inspireFly-VT/ContentCube_Payload_Board/README.md

View this project on [CADLAB.io](https://cadlab.io/project/28566). 

# ContentCube_Payload_Board
The payload board for inspireFly's ContentCube satellite.
