inspireFly-VT/ContentCube_Payload_Board/Documentation/Adafruit-1.5-display/camera_oled_software/inspireFly_soft_09_06_2024_1206/README.md

# Functional-OLED-and-Camera-Program
Working software to display on the ADAFruit SSD1351 and capture images from the Arducam 3MP on one main program. Documentation is WIP.
