inspireFly-VT/ContentCube_Payload_Board/Payload_BlockDiagram.pptx

inspireFly Payload Board Block Diagram– 10/10/2023 – L.V.

* Camera has I2C connectivity for “config/setup” (optional)

Number markings indicate importance

RP2040

Flight
Controller

1

Camera

2

I2C*

I2C

Display

SPI

3

RP2040

Payload Controller

QSPI

QSPI

External
Flash

Both may not be required

5

SD Card

4
