inspireFly-VT/ContentCube_Payload_Board/Documentation/Adafruit-1.5-display/camera_oled_software/inspireFly_soft_08_25_24_1240/inspireFly_Capture_0.jpg

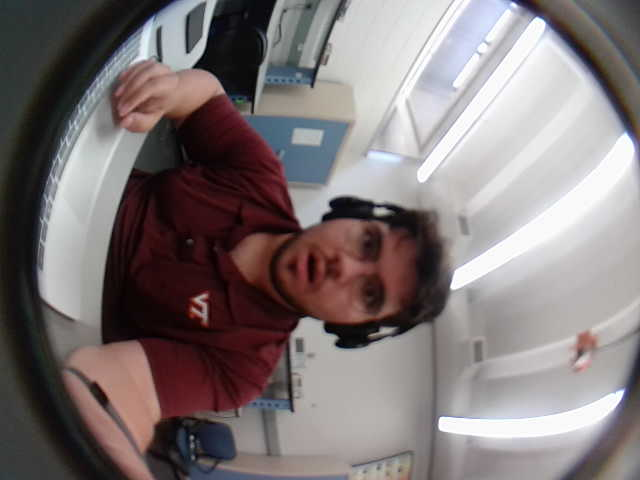
Documentation/Adafruit-1.5-display/camera_oled_software/inspireFly_soft_08_25_24_1240/inspireFly_Capture_0.jpg
