inspireFly-VT/ContentCube_Payload_Board/Documentation/Adafruit-1.5-display/camera_oled_software/inspireFly_soft_09_06_2024_1206/inspireFly_Capture_2.jpg

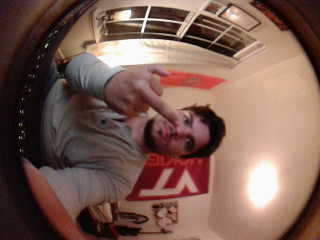
Documentation/Adafruit-1.5-display/camera_oled_software/inspireFly_soft_09_06_2024_1206/inspireFly_Capture_2.jpg
