inspireFly-VT/ContentCube_Payload_Board/Manufacturing/payload_board.xlsx

Sheet: payload_board_1
Id | Designator | Footprint | Quantity | Designation | JLC PN | DK PN | Inv | Needed | Column2
26 | C13 | C_1206_3216Metric_Pad1.33x1.80mm_HandSolder | 1 | 22uF |  | 1276-3148-2-ND | 1 | 4
11 | C12 | C_1206_3216Metric_Pad1.33x1.80mm_HandSolder | 1 | 10uF |  | 1276-6641-1-ND | 8 | 0
8 | C19,C14,C6,C23,C22 | C_0402_1005Metric_Pad0.74x0.62mm_HandSolder | 5 | 1uF | C77006
6 | C2,C1 | C_0402_1005Metric_Pad0.74x0.62mm_HandSolder | 2 | 27pF | C86287 |  | 10
18 | C20,C21,C24 | C_0603_1608Metric_Pad1.08x0.95mm_HandSolder | 2 | 10uF/16V | C962136 |  | 27
31 | C26 | R_0805_2012Metric_Pad1.20x1.40mm_HandSolder | 1 | 4.7uF |  | 1276-1244-1-ND | 2 | 3
2 | C8,C10,C7,C4,C16,C5,C15,C11,C17,C9 | C_0402_1005Metric_Pad0.74x0.62mm_HandSolder | 10 | 0.1uF | C60474 |  | 30
44 | D2 | LED_0805_2012Metric | 1 | LED BL |  | 732-4982-1-ND | 3 | 2
 | D3 | LED_0805_2012Metric | 1 | LED GR |  |  | 6 | 0
 | D4 | LED_0805_2012Metric | 1 | LED RED |  | 732-4984-1-ND | 2 | 3
3 | D7,D1,D5 | D_SOD-323 | 3 | NSR0320 | C48192
19 | IC1 | custom_IC57_RP2040 | 1 | RP2040_QFN56 | C2040
35 | IC2 | SOT230P700X180-4N | 1 | AZ1117CH-3.3TRG1 |  | AZ1117CH-3.3TRG1DICT-ND | 5 | 0
14 | J1,J6 | Molex_Pico_CON_5040500691 | 2 | Cam_PicoLock, Breakout |  | WM10143CT-ND | 6 | 4
27 | J10 | MOLEX_503398-1892 | 1 | 503398-1892 |  | WM11190CT-ND | 4 | 1
32 | J3 | Molex_Pico_CON_5040500491 | 1 | Antenna_Conn |  | WM10137CT-ND | 2 | 3
46 | J7 | MOLEX_105164-0001 | 1 | Molex_Micro_USB |  | WM11263CT-ND | 1 | 4
4 | J8 | MOLEX_504050-0291 | 1 | FC to EPS Connector |  | WM25693CT-ND | 3 | 2
29 | L1 | L_1008_2520Metric_Pad1.43x2.20mm_HandSolder | 1 | 10uH/1A |  | 535-AOTA-B252010S100MTCT-ND | 2 | 3
24 | Q1 | SC-59 | 1 | Q_PMOS_GSD | C2589
43 | R10,R12 | R_0402_1005Metric_Pad0.72x0.64mm_HandSolder | 2 | 220 |  | 2019-RK73H1ETTP2200FCT-ND | 10 | 0
47 | R11 | R_0402_1005Metric_Pad0.72x0.64mm_HandSolder | 1 | 820 |  |  | 0 | 5
5 | R13,R14 | R_1206_3216Metric_Pad1.30x1.75mm_HandSolder | 2 | 0.065 | C20608721 |  | 7
33 | R15,R16 | R_0603_1608Metric_Pad0.98x0.95mm_HandSolder | 2 | 300k | C138011
1 | R19 | R_0603_1608Metric_Pad0.98x0.95mm_HandSolder | 1 | 50 | C853312
15 | R20 | R_0805_2012Metric_Pad1.20x1.40mm_HandSolder | 1 | 16k |  | 2019-RK73H2ATTD1002FTR-ND | 1 | 4
16 | R3,R1,R8,R9 | R_0402_1005Metric_Pad0.72x0.64mm_HandSolder | 3 | 10k | C144731 |  | 6
12 | R5,R6 | R_0402_1005Metric_Pad0.72x0.64mm_HandSolder | 2 | 27.4 | C274349
7 | R7,R2,R21 | R_0402_1005Metric_Pad0.72x0.64mm_HandSolder | 2 | 1K | C136974 |  | 20
38 | SW2,SW1 | SW_Push_1P1T_NO_CK_KMR2 | 2 | KMR2 | C221675
25 | U1 | WDFN-8-1EP_6x5mm_P1.27mm_EP3.4x4mm | 1 | W25Q128JVPIQ TR | C190862
37 | U2 | SOIC-8_3.9x4.9mm_P1.27mm | 1 | MAX706RESA |  | MAX706RESA+CT-ND | 3 | 2
9 | U4,U3 | SOT-23-5 | 2 | INA180A3 |  | 296-47654-1-ND | 4 | 6
28 | U6 | CON30_1X30_DRB_XF2C_TYC | 1 | ~ | C3041205
30 | U7 | SOT-23-6 | 1 | TLV61046ADB | C464815
34 | Y1 | Crystal_SMD_5032-2Pin_5.0x3.2mm | 1 | ABLS-12.000MHZ-B2-T |  | CTX1162CT-ND | 0 | 5

Sheet: payload_board_074 (4)
Id | Designator | Footprint | Quantity | Designation | JLC PN | DK PN | Inv | Needed | Column2
26 | C13 | C_1206_3216Metric_Pad1.33x1.80mm_HandSolder | 1 | 22uF |  | 1276-3148-2-ND | 6 | 0
11 | C12 | C_1206_3216Metric_Pad1.33x1.80mm_HandSolder | 1 | 10uF |  | 1276-6641-1-ND | 8 | 0
8 | C19,C14,C6,C23,C22 | C_0402_1005Metric_Pad0.74x0.62mm_HandSolder | 5 | 1uF | C77006
6 | C2,C1 | C_0402_1005Metric_Pad0.74x0.62mm_HandSolder | 2 | 27pF | C86287
18 | C20,C21,C24 | C_0603_1608Metric_Pad1.08x0.95mm_HandSolder | 2 | 10uF/16V | C962136
31 | C26 | R_0805_2012Metric_Pad1.20x1.40mm_HandSolder | 1 | 4.7uF |  | 1276-1244-1-ND | 0 | 5
2 | C8,C10,C7,C4,C16,C5,C15,C11,C17,C9 | C_0402_1005Metric_Pad0.74x0.62mm_HandSolder | 10 | 0.1uF | C60474
44 | D2 | LED_0805_2012Metric | 1 | LED BL |  | 732-4982-1-ND | 3 | 2
 | D3 | LED_0805_2012Metric | 1 | LED GR |  |  | 6 | 0
 | D4 | LED_0805_2012Metric | 1 | LED RED |  | 732-4984-1-ND | 0 | 5
3 | D7,D1,D5 | D_SOD-323 | 3 | NSR0320 | C48192
19 | IC1 | custom_IC57_RP2040 | 1 | RP2040_QFN56 | C2040
35 | IC2 | SOT230P700X180-4N | 1 | AZ1117CH-3.3TRG1 |  | AZ1117CH-3.3TRG1DICT-ND | 10 | 0
14 | J1,J6 | Molex_Pico_CON_5040500691 | 2 | Cam_PicoLock, Breakout |  | WM10143CT-ND | 9 | 1
27 | J10 | MOLEX_503398-1892 | 1 | 503398-1892 |  | WM11190CT-ND | 6 | 0
32 | J3 | Molex_Pico_CON_5040500491 | 1 | Antenna_Conn |  | WM10137CT-ND | 5 | 0
46 | J7 | MOLEX_105164-0001 | 1 | Molex_Micro_USB |  | WM11263CT-ND | 1 | 4
4 | J8 | MOLEX_504050-0291 | 1 | FC to EPS Connector |  | WM25693CT-ND | 5 | 0
29 | L1 | L_1008_2520Metric_Pad1.43x2.20mm_HandSolder | 1 | 10uH/1A |  | 535-AOTA-B252010S100MTCT-ND | 5 | 0
24 | Q1 | SC-59 | 1 | Q_PMOS_GSD | C2589
43 | R10,R12 | R_0402_1005Metric_Pad0.72x0.64mm_HandSolder | 2 | 220 |  | 2019-RK73H1ETTP2200FCT-ND | 10 | 0
47 | R11 | R_0402_1005Metric_Pad0.72x0.64mm_HandSolder | 1 | 470 |  | 2019-RK73H1ETTP4700FTR-ND | 3 | 2
5 | R13,R14 | R_1206_3216Metric_Pad1.30x1.75mm_HandSolder | 2 | 0.065 | C20608721
33 | R15,R16 | R_0603_1608Metric_Pad0.98x0.95mm_HandSolder | 2 | 300k | C138011
1 | R19 | R_0603_1608Metric_Pad0.98x0.95mm_HandSolder | 1 | 50 | C853312
15 | R20 | R_0805_2012Metric_Pad1.20x1.40mm_HandSolder | 1 | 16k |  | 2019-RK73H2ATTD1002FTR-ND | 0 | 5
16 | R3,R1,R8,R9 | R_0402_1005Metric_Pad0.72x0.64mm_HandSolder | 3 | 10k | C144731
12 | R5,R6 | R_0402_1005Metric_Pad0.72x0.64mm_HandSolder | 2 | 27.4 | C274349
7 | R7,R2,R21 | R_0402_1005Metric_Pad0.72x0.64mm_HandSolder | 2 | 1K | C136974
38 | SW2,SW1 | SW_Push_1P1T_NO_CK_KMR2 | 2 | KMR2 | C221675
25 | U1 | WDFN-8-1EP_6x5mm_P1.27mm_EP3.4x4mm | 1 | W25Q128JVPIQ TR | C190862
37 | U2 | SOIC-8_3.9x4.9mm_P1.27mm | 1 | MAX706RESA |  | MAX706RESA+CT-ND | 5 | 0
9 | U4,U3 | SOT-23-5 | 2 | INA180A3 |  | 296-47654-1-ND | 3 | 7
28 | U6 | CON30_1X30_DRB_XF2C_TYC | 1 | ~ | C3041205
30 | U7 | SOT-23-6 | 1 | TLV61046ADB | C464815
34 | Y1 | Crystal_SMD_5032-2Pin_5.0x3.2mm | 1 | ABLS-12.000MHZ-B2-T |  | CTX1162CT-ND | 0 | 5

Sheet: payload_board_074
Id | Designator | Footprint | Quantity | Designation | JLC PN | Column1 | _1
39 | C12 | C_1206_3216Metric_Pad1.33x1.80mm_HandSolder | 1 | 10uF
24 | C13 | C_1206_3216Metric_Pad1.33x1.80mm_HandSolder | 1 | 22uF
8 | C2,C1 | C_0402_1005Metric_Pad0.74x0.62mm_HandSolder | 2 | 27pF | C86287
2 | C21,C20 | C_0603_1608Metric_Pad1.08x0.95mm_HandSolder | 2 | 10uF/16V | C962136
20 | C23,C14,C6,C22 | C_0402_1005Metric_Pad0.74x0.62mm_HandSolder | 4 | 1uF | C77006
1 | C24,C19,C18 | C_0603_1608Metric_Pad1.08x0.95mm_HandSolder | 3 | 10uF | C962136
4 | C8,C10,C7,C4,C16,C5,C15,C25,C11,C17,C9 | C_0402_1005Metric_Pad0.74x0.62mm_HandSolder | 11 | 0.1uF | C60474
41 | D2,D3,D4 | LED_0805_2012Metric | 3 | LED | C7371915
5 | D7,D9,D1,D5 | D_SOD-323 | 4 | NSR0320 | C48192
18 | IC1 | custom_IC57_RP2040 | 1 | RP2040_QFN56 | C2040
31 | IC2 | SOT230P700X180-4N | 1 | AZ1117CH-3.3TRG1
42 | J_Burn | Burn_Wire_Connection | 1 | Conn_01x02
15 | J1 | Molex_Pico_CON_5040500691 | 1 | Cam_PicoLock
25 | J10 | MOLEX_503398-1892 | 1 | 503398-1892
21 | J12 | PinHeader_1x02_P2.54mm_Vertical | 1 | FC Breakout
16 | J15 | PinHeader_1x06_P2.54mm_Vertical | 1 | SWC
14 | J2 | PinHeader_1x06_P2.54mm_Vertical | 1 | Cam_Conn
27 | J3 | Molex_Pico_CON_5040500491 | 1 | Antenna_Conn
19 | J4 | SolderJumper-2_P1.3mm_Open_TrianglePad1.0x1.5mm | 1 | usb jumper
35 | J6 | Molex_Pico_CON_5040500691 | 1 | Breakout
43 | J7 | MOLEX_105164-0001 | 1 | Molex_Micro_USB
6 | J8 | MOLEX_504050-0291 | 1 | FC to EPS Connector
37 | L1 | L_1008_2520Metric_Pad1.43x2.20mm_HandSolder | 1 | 10uH/1A
22 | Q1 | SC-59 | 1 | Q_PMOS_GSD | C2589
40 | R10,R12 | R_0402_1005Metric_Pad0.72x0.64mm_HandSolder | 2 | 220 | C112291
44 | R11 | R_0402_1005Metric_Pad0.72x0.64mm_HandSolder | 1 | 470 | C114949
7 | R13,R14 | R_1206_3216Metric_Pad1.30x1.75mm_HandSolder | 2 | 0.065 | C20608721
29 | R15,R16 | R_0402_1005Metric_Pad0.72x0.64mm_HandSolder | 2 | 300k | C138011
28 | R17 | R_0402_1005Metric_Pad0.72x0.64mm_HandSolder | 1 | 100k | C106234
12 | R18,R3,R1,R9,R8 | R_0402_1005Metric_Pad0.72x0.64mm_HandSolder | 5 | 10k | C144731
3 | R19 | R_0402_1005Metric_Pad0.72x0.64mm_HandSolder | 1 | 50 | C853312
13 | R5,R6 | R_0402_1005Metric_Pad0.72x0.64mm_HandSolder | 2 | 27.4 | C274349
9 | R7,R2 | R_0402_1005Metric_Pad0.72x0.64mm_HandSolder | 2 | 1K | C136974
33 | SW2,SW1 | SW_Push_1P1T_NO_CK_KMR2 | 2 | KMR2 | C221675
23 | U1 | WDFN-8-1EP_6x5mm_P1.27mm_EP3.4x4mm | 1 | W25Q128JVPIQ TR | C190862
32 | U2 | SOIC-8_3.9x4.9mm_P1.27mm | 1 | MAX706RESA
10 | U4,U3 | SOT-23-5 | 2 | INA180A3
36 | U7 | SOT-23-6_HandSoldering | 1 | TLV61046ADB | C464815
26 | U6 | CON30_1X30_DRB_XF2C_TYC | 1 | 30POSFPC | C3041205
30 | Y1 | Crystal_SMD_5032-2Pin_5.0x3.2mm_HandSoldering | 1 | ABLS-12.000MHZ-B2-T

Sheet: payload board 0.7.3
Id | Designator | Footprint | Quantity | Designation | Inventory | Needed | Order Quantity | Part Number (Digikey) | Part Number JLC
1 | C12 | C_1206_3216Metric_Pad1.33x1.80mm_HandSolder | 1 | 10uF | 11 | 6 | 0 | 1276-6641-1-ND
2 | C13 | C_1206_3216Metric_Pad1.33x1.80mm_HandSolder | 1 | 22uF | 11 | 6 | 0 | 1276-6641-1-ND
3 | C14,C6 | C_0402_1005Metric_Pad0.74x0.62mm_HandSolder | 2 | 1uF | 7 | 11 | 4 | 490-18216-1-ND | C346194
4 | C18,C24,C19 | C_0603_1608Metric_Pad1.08x0.95mm_HandSolder | 3 | 10uF | 0 | 16 | 16 | 490-12286-1-ND | C962136
5 | C2,C1 | C_0402_1005Metric_Pad0.74x0.62mm_HandSolder | 2 | 27pF | 7 | 11 | 4 | 490-12651-1-ND
6 | C20,C21 | C_0603_1608Metric_Pad1.08x0.95mm_HandSolder | 2 | 10uF/16V | 0 | 11 | 11 | 490-12286-1-ND | C962136
7 | C23,C22 | C_0603_1608Metric_Pad1.08x0.95mm_HandSolder | 2 | 1.0uF | 47 | 11 | 0 | 1276-1946-1-ND
8 | C25 | C_0603_1608Metric_Pad1.08x0.95mm_HandSolder | 1 | 0.1uF | 53 | 6 | 0 | 1276-1935-1-ND
9 | C8,C10,C7,C4,C5,C15,C11,C9,C16,C17 | C_0402_1005Metric_Pad0.74x0.62mm_HandSolder | 10 | 0.1uF | 18 | 52 | 34 | 399-C0402C104K4RACTUCT-ND | C60474
10 | D1,D7,D9,D5 | D_SOD-323 | 4 | NSR0320 | 8 | 21 | 13 | NSR0320MW2T1GOSCT-ND | C48192
11 | D2,D3,D4 | LED_0805_2012Metric | 3 | LED | 21 | 16 | 0 | 3147-B1701UYG-20D000114U1930CT-ND | C6795835
12 | IC1 | custom_IC57_RP2040 | 1 | RP2040_QFN56 | 4 | 6 | 2 | 2648-SC0914(13)CT-ND | C2040
13 | IC2 | SOT230P700X180-4N | 1 | AZ1117CH-3.3TRG1 | 14 | 6 | 0 | AZ1117CH-3.3TRG1DICT-ND
14 | J10 | MOLEX_503398-1892 | 1 | SD_Card | 0 | 6 | 6 | WM11190CT-ND | GS
15 | J3 | Molex_Pico_CON_5040500491 | 1 | Antenna_Conn | 4 | 6 | 2 | WM10137CT-ND | GS
16 | J1,J6 | Molex_Pico_CON_5040500691 | 2 | Breakout | 0 | 11 | 11 | WM10143CT-ND | C563981
17 | J7 | MOLEX_105164-0001 | 1 | Molex_Micro_USB | 4 | 6 | 2 | WM11263CT-ND | GS
18 | J8 | Molex_Pico_CON_504050-0291 | 1 | FC to EPS Connector | 6 | 6 | 0 | WM25693CT-ND | GS
19 | L1 | L_1008_2520Metric_Pad1.43x2.20mm_HandSolder | 1 | 10uH/1A | 0 | 6 | 6 | 535-AOTA-B252010S100MTCT-ND | GS
20 | Q1 | SC-59 | 1 | Q_PMOS_GSD | 4 | 6 | 2 | TSM500P02CXRFGCT-ND | GS
21 | R1,R3,R8 | R_0402_1005Metric_Pad0.72x0.64mm_HandSolder | 3 | 10K | 6 | 16 | 10 | 2019-RK73H1ETTP1002FCT-ND | C131361
22 | R10,R12 | R_0402_1005Metric_Pad0.72x0.64mm_HandSolder | 2 | 220 | 5 | 11 | 6 | 2019-RK73H1ETTP2200FCT-ND | C112291
23 | R11 | R_0402_1005Metric_Pad0.72x0.64mm_HandSolder | 1 | 470 | 7 | 6 | 0 | 2019-RK73H1ETTP4700FCT-ND | C144711
24 | R13,R14 | R_1206_3216Metric_Pad1.30x1.75mm_HandSolder | 2 | 0.065 | 8 | 11 | 3 | 541-10061-1-ND | GS
25 | R15,R16 | R_0603_1608Metric_Pad0.98x0.95mm_HandSolder | 2 | 300k | 0 | 11 | 11 | P300KBYCT-ND | C114667
26 | R17 | R_0603_1608Metric_Pad0.98x0.95mm_HandSolder | 1 | 100k | 0 | 6 | 6 | 2019-RK73H1JTTD1003FCT-ND | C116674
27 | R18 | R_0603_1608Metric_Pad0.98x0.95mm_HandSolder | 1 | 10k | 21 | 6 | 0 | 2019-RK73H1JTTD1002FCT-ND
28 | R19 | R_0603_1608Metric_Pad0.98x0.95mm_HandSolder | 1 | 50 | 0 | 6 | 6 | 541-3318-1-ND
29 | R5,R6 | R_0402_1005Metric_Pad0.72x0.64mm_HandSolder | 2 | 27.4 | 5 | 11 | 6 | 2019-RK73H1ETTP27R4FCT-ND | C274349
30 | R7,R2 | R_0402_1005Metric_Pad0.72x0.64mm_HandSolder | 2 | 1K | 11 | 11 | 0 | 2019-RK73H1ETTP1001FCT-ND | C136974
31 | R9 | PinSocket_1x02_P2.54mm_Vertical | 1 | 10k | 6 | 6 | 0 | S7035-ND
32 | SW2,SW1 | SW_Push_1P1T_NO_CK_KMR2 | 2 | KMR2 | 7 | 11 | 4 | 401-1427-1-ND | C221675
33 | U1 | WDFN-8-1EP_6x5mm_P1.27mm_EP3.4x4mm | 1 | W25Q128JVPIQ TR | 6 | 6 | 0 | W25Q128JVPIMCT-ND | C190862
34 | U2 | SOIC-8_3.9x4.9mm_P1.27mm | 1 | MAX706RESA | 3 | 6 | 3 | MAX706RESA+CT-ND | C28380
35 | U4,U3 | SOT-23-5 | 2 | INA180A3 | 7 | 11 | 4 | 296-47654-1-ND | C122882
36 | U6 | CON30_1X30_DRB_XF2C_TYC | 1 | XF2M-3015-1A | 0 | 6 | 6 | OR723TR-ND
37 | Y1 | Crystal_SMD_5032-2Pin_5.0x3.2mm_HandSoldering | 1 | ABLS-12.000MHZ-B2-T | 4 | 6 | 2 | CTX1162CT-ND | GS
38 | N/A | N/A | 2 | EPS Burn FET | 0 | 11 | 4 | 742-SQ4401CEY-T1_GE3CT-ND

Sheet: My Lists Worksheet
Index | Delivered? | Manufacturer Part Number | Manufacturer Name | Description | Order Quantity | Digi-Key Part Number 1 | Unit Price 1 | Extended Price 1 |  | Quantity (pcs) | Quantity Box (pcs)
1 |  | SC0914(13) | Raspberry Pi | IC MCU 32BIT EXT MEM 56QFN | 8 | 2648-SC0914(13)CT-ND | $0.70 | $5.60 | https://www.digikey.com/en/products/detail/raspberry-pi/SC0914-13/14306010 | 4 | 4
2 |  | AZ1117CH-3.3TRG1 | Diodes Incorporated | IC REG LINEAR 3.3V 1A SOT223 | 8 | AZ1117CH-3.3TRG1DICT-ND | $0.45 | $3.60
3 |  | NSR0320MW2T1G | onsemi | DIODE SCHOTTKY 20V 1A SOD323 | 8 | NSR0320MW2T1GOSCT-ND | $0.32 | $2.56 | https://www.digikey.com/en/products/detail/onsemi/NSR0320MW2T1G/1218949 | 10 | 8
4 |  | ABLS-12.000MHZ-B2-T | Abracon LLC | CRYSTAL 12.0000MHZ 18PF SMD | 6 | 535-9067-1-ND | $0.24 | $1.44 | https://www.digikey.com/en/products/detail/abracon-llc/ABLS-12-000MHZ-B2-T/675262 | 5 | 4
5 |  | 1051640001 | Molex | CONN RCPT USB2.0 MICRO B SMD R/A | 5 | WM11263CT-ND | $1.03 | $5.15 | https://www.digikey.com/en/products/detail/molex/1051640001/4555286 | 5 | 4
6 |  | PPPC111LFBN-RC | Sullins Connector Solutions | CONN HDR 11POS 0.1 GOLD PCB | 4 | S7044-ND | $0.75 | $3.00
7 |  | PPPC081LFBN-RC | Sullins Connector Solutions | CONN HDR 8POS 0.1 GOLD PCB | 4 | S7041-ND | $0.68 | $2.72
8 |  | 5040501291 | Molex | CONN HEADER SMD R/A 12POS 1.5MM | 4 | WM16219CT-ND | $2.15 | $8.60 | https://www.digikey.com/en/products/detail/molex/5040501291/5154625 | 3
9 |  | 5040500891 | Molex | CONN HEADER SMD R/A 8POS 1.5MM | 4 | WM14421CT-ND | $1.53 | $6.12 | https://www.digikey.com/en/products/detail/molex/5040500891/4693487 | 4
10 |  | 5040500291 | Molex | CONN HEADER SMD R/A 2POS 1.5MM | 6 | WM25693CT-ND | $1.00 | $6.00 | https://www.digikey.com/en/products/detail/molex/5040500291/9954115 | 4 | 6
11 |  | 5040500491 | Molex | CONN HEADER SMD R/A 4POS 1.5MM | 4 | WM10137CT-ND | $1.04 | $4.16 | https://www.digikey.com/en/products/detail/molex/5040500491/4357649 | 4 | 4
12 |  | W25Q128JVPIM TR | Winbond Electronics | IC FLASH 128MBIT SPI/QUAD 8WSON | 8 | W25Q128JVPIMCT-ND | $1.72 | $13.76
14 |  | KMR221GLFS | C&K | SWITCH TACTILE SPST-NO 0.05A 32V | 10 | 401-1427-1-ND | $0.51 | $5.07 | https://www.digikey.com/en/products/detail/sullins-connector-solutions/PPPC021LFBN-RC/810174 | 7 | 7
15 |  | C0603C270F3HACAUTO | KEMET | CAP CER 0603 27PF 25V ULTRA STAB | 10 | 399-C0603C270F3HACAUTOCT-ND | $0.13 | $1.30 | https://www.digikey.com/en/products/detail/kemet/C0603C270F3HACAUTO/7956447 | 18
16 |  | CL31B106MOHNNNE | Samsung Electro-Mechanics | CAP CER 10UF 16V X7R 1206 | 10 | 1276-6641-1-ND | $0.13 | $1.31 | https://www.digikey.com/en/products/detail/samsung-electro-mechanics/CL31B106MOHNNNE/5961125 | 14 | 11
17 |  | CL31B226MPHNNNE | Samsung Electro-Mechanics | CAP CER 22UF 10V X7R 1206 | 10 | 1276-3148-1-ND | $0.23 | $2.25 | https://www.digikey.com/en/products/detail/samsung-electro-mechanics/CL31B226MPHNNNE/3888806 | 14 | 11
18 |  | CL10B105KP8NNNC | Samsung Electro-Mechanics | CAP CER 1UF 10V X7R 0603 | 30 | 1276-1946-1-ND | $0.04 | $1.08 | https://www.digikey.com/en/products/detail/samsung-electro-mechanics/CL10B105KP8NNNC/3887604 | 47 | 47
19 |  | CL10B104KB8NNWC | Samsung Electro-Mechanics | CAP CER 0.1UF 50V X7R 0603 | 50 | 1276-1935-1-ND | $0.01 | $0.51 | https://www.digikey.com/en/products/detail/samsung-electro-mechanics/CL10B104KB8NNWC/3887593 | 53 | 53
21 |  | RK73H1JTTD1002F | KOA Speer Electronics, Inc. | RES 10K OHM 1% 1/10W 0603 | 20 | 2019-RK73H1JTTD1002FCT-ND | $0.02 | $0.42 | https://www.digikey.com/en/products/detail/koa-speer-electronics-inc/RK73H1JTTD1002F/9844954 | 21 | 21
22 |  | RK73H1JTTD1001F | KOA Speer Electronics, Inc. | RES 1K OHM 1% 1/8W 0603 | 20 | 2019-RK73H1JTTD1001FCT-ND | $0.02 | $0.42 | https://www.digikey.com/en/products/detail/koa-speer-electronics-inc/RK73H1JTTD1001F/9844844 | 24
23 |  | RK73H1JTTD27R4F | KOA Speer Electronics, Inc. | RES 27.4 OHM 1% 1/8W 0603 | 20 | 2019-RK73H1JTTD27R4FCT-ND | $0.02 | $0.42 | https://www.digikey.com/en/products/detail/koa-speer-electronics-inc/RK73H1JTTD27R4F/9845149 | 28
24 |  | B1701UYG-20D000114U1930 | Harvatek Corporation | LED YLW-GRN DIFFUSED 0805 SMD | 30 | 3147-B1701UYG-20D000114U1930CT-ND | $0.09 | $2.76 | https://www.digikey.com/en/products/detail/harvatek-corporation/B1701UYG-20D000114U1930/16671747 | 21 | 21
25 |  | TSM500P02CX RFG | Taiwan Semiconductor Corporation | MOSFET P-CHANNEL 20V 4.7A SOT23 | 10 | TSM500P02CXRFGCT-ND | $0.50 | $5.00 | https://www.digikey.com/en/products/detail/taiwan-semiconductor-corporation/TSM500P02CX-RFG/7360423 | 7 | 4
26 |  | WSL1206R0650FEA | Vishay Dale | RES 0.065 OHM 1% 1/4W 1206 | 20 | 541-10061-1-ND | $0.80 | $16.02 | https://www.digikey.com/en/products/detail/vishay-dale/WSL1206R0650FEA/9758329 | 14 | 8
27 |  | 20021121-00008C4LF | Amphenol ICC (FCI) | CONN HEADER SMD 8POS 1.27MM | 10 | 609-3694-1-ND | 0.671 | $6.71 | https://www.digikey.com/en/products/detail/amphenol-cs-fci/20021121-00008C4LF/2209054 | 10
28 |  | SC0889 | Raspberry Pi | RASPBERRY PI DEBUG PROBE | 1 | 2648-SC0889-ND | $12.00 | $12.00
29 |  | INA180A3IDBVR | Texas Instruments | IC CURR SENSE 1 CIRCUIT SOT23-5 | 15 | 296-47654-1-ND | $0.34 | $5.12 | https://www.digikey.com/en/products/detail/texas-instruments/INA180A3IDBVR/8132988 | 9 | 7
30 |  | PPPC061LGBN-RC | Sullins Connector Solutions | CONN HDR 6POS 0.1 GOLD PCB R/A | 10 | S5481-ND | $0.57 | $5.66
31 |  | MAX706RESA + T |  | MAX706RESA + T |  | 5402462 |  |  |  | 1 | 3
32 |  | PPPC021LFBN-RC | Sullins Connector Solutions | CONN HDR 2POS 0.1 GOLD PCB |  | 810173 |  |  |  | 7
33 |  | 5033981892 | Molex | MICRO SD PUSH/PUSH SMALL 8C (https://www.digikey.com/short/tpwbdmf4) |  | WM11190TR-ND
34 |  | XF2M-3015-1A | Omron Electronics Inc-EMC Div | CONN FPC 30POS 0.5MM R/A (https://www.digikey.com/short/32d9dhdj) |  | OR723TR-ND
35 |  | FAN5331SX | Onsemi | DC-DC Switching Boost (Step Up) Regulator (https://www.newark.com/onsemi/fan5331sx/dc-dc-switching-boost-step-up/dp/87X8713) | 25
 |  | AOTA-B252010S100MT | Abracon LLC | FIXED IND 10UH 1.2A 420MOHM SMD (https://www.digikey.com/short/7hjjb4vv) |  | 535-AOTA-B252010S100MTCT-ND
 |  |  |  |  |  |  | Total Price | $128.76
 |  |  |  |  |  |  | Total Price | $128.76
