inspireFly-VT/ContentCube_Payload_Board/Documentation/Board_outline/payload_board_rev073_outline.DXF

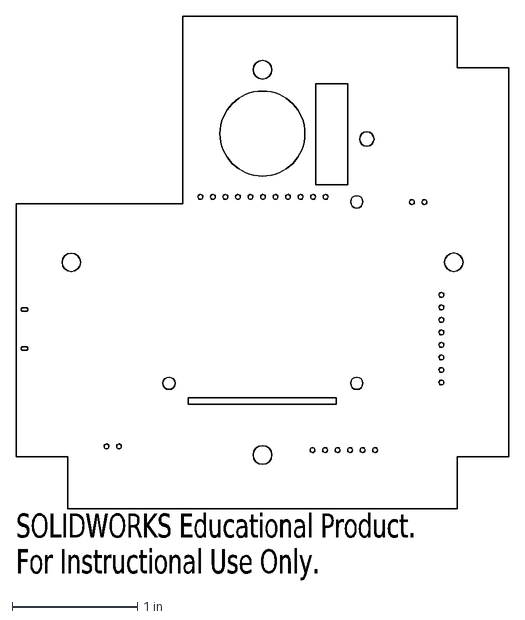
[picture p13: CAD file, 2024-12-05]
Documentation/Board_outline/payload_board_rev073_outline.DXF
SOLIDWORKS Educational Product.
For Instructional Use Only.
