inspireFly-VT/ContentCube_Payload_Board/Manufacturing/payload_board_rev074_gbr/payload_board-B_Cu.pdf

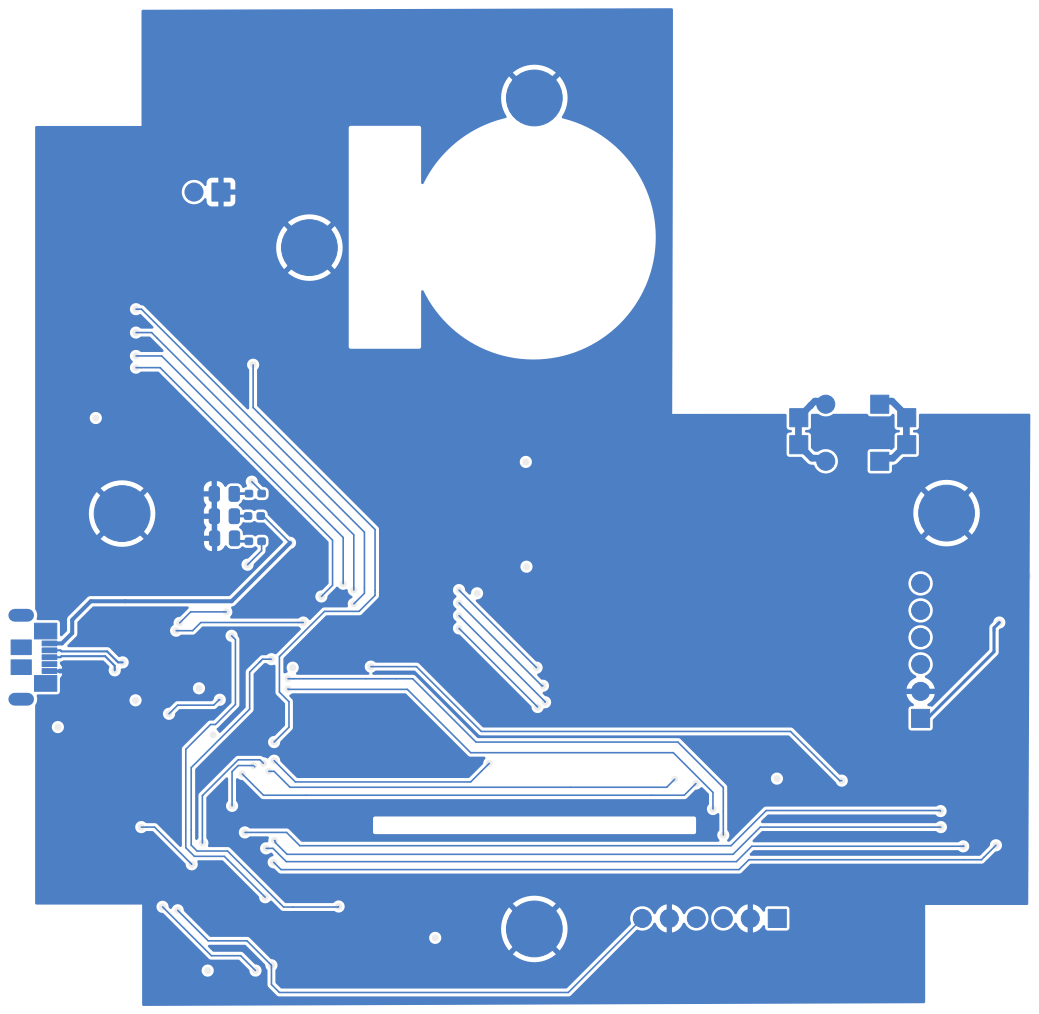
[picture p14: page 1]
