inspireFly-VT/ContentCube_Payload_Board/Manufacturing/payload_board_rev074_gbr/payload_board-B_Mask.pdf

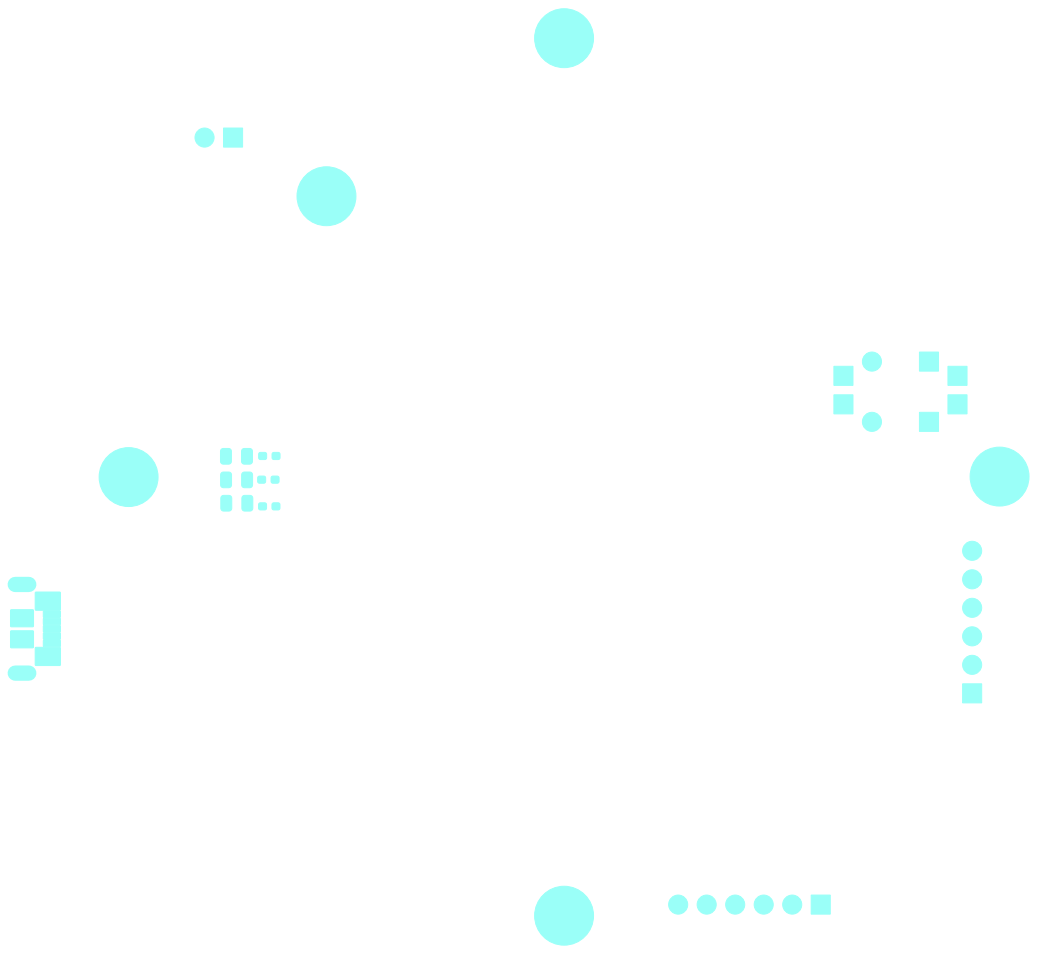
[picture p15: page 1]
