inspireFly-VT/ContentCube_Payload_Board/Manufacturing/payload_board_rev074_gbr/payload_board-B_Silkscreen.pdf

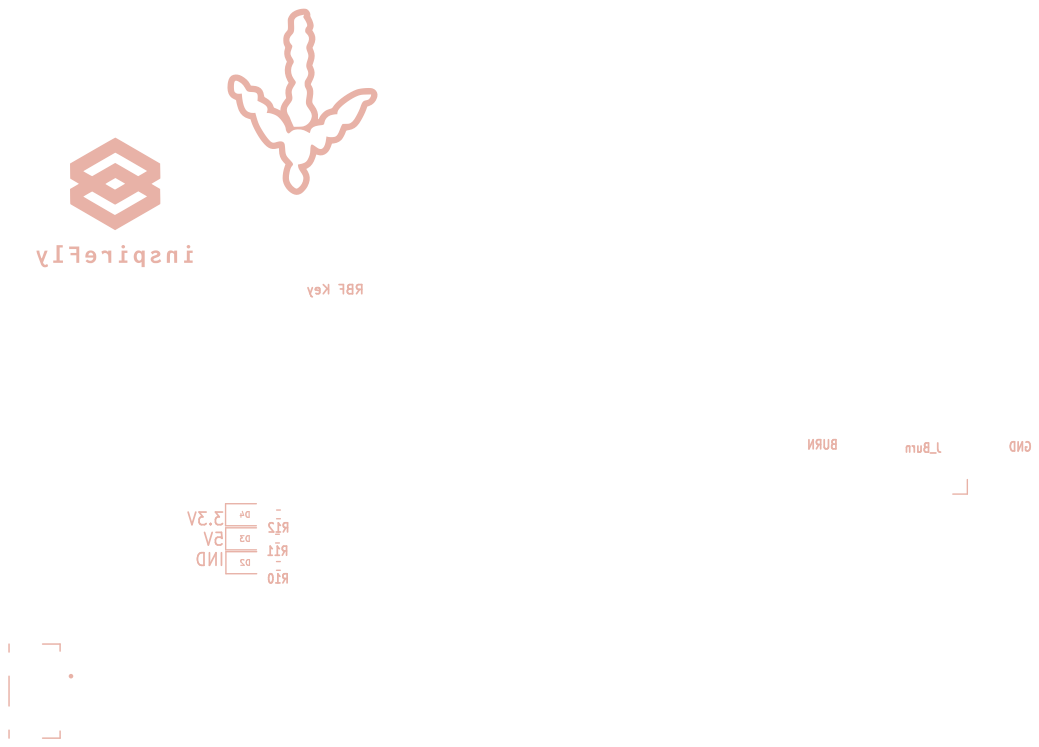
[picture p16: page 1]
