inspireFly-VT/ContentCube_Payload_Board/Manufacturing/payload_board_rev074_gbr/payload_board-Edge_Cuts.pdf

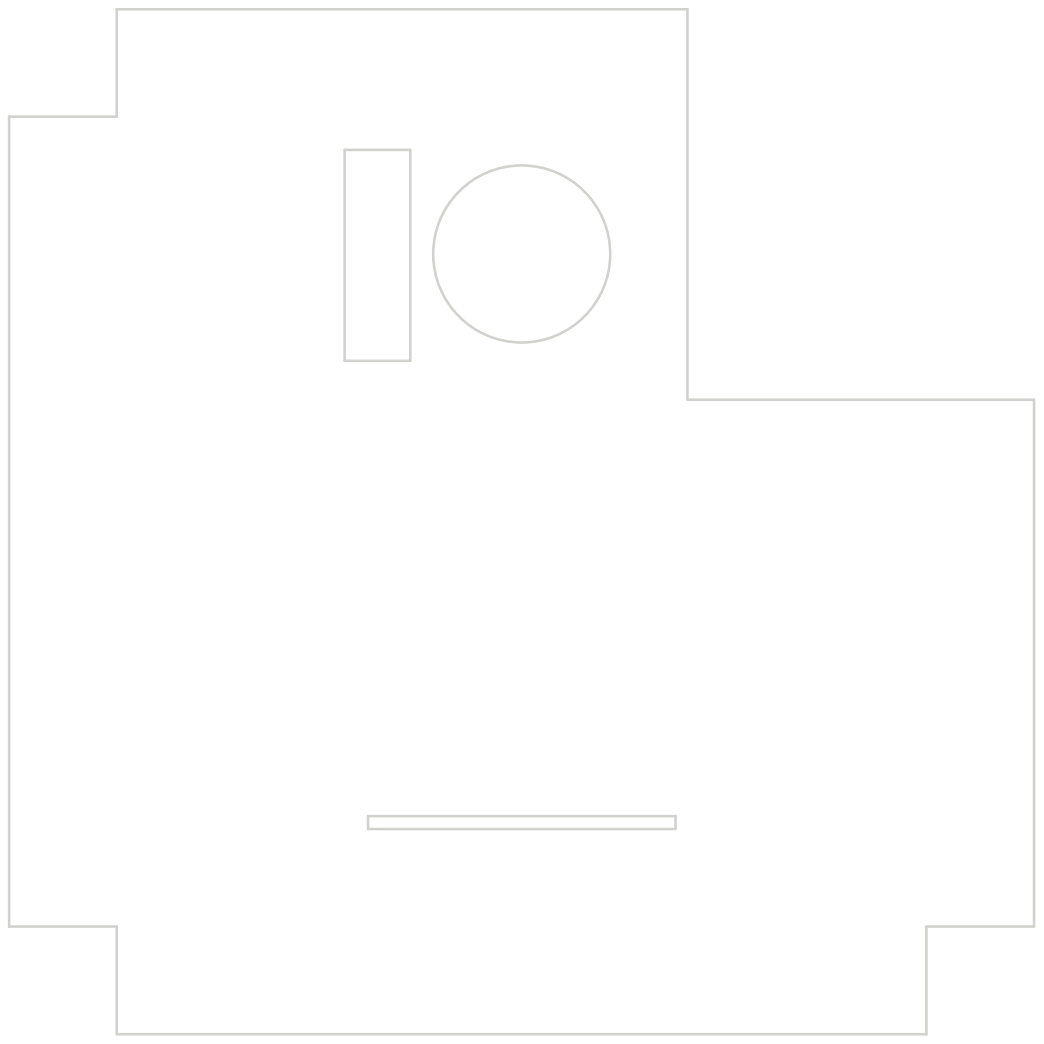
[picture p17: page 1]
