inspireFly-VT/ContentCube_Payload_Board/Manufacturing/payload_board_rev074_gbr/payload_board-F_Cu.pdf

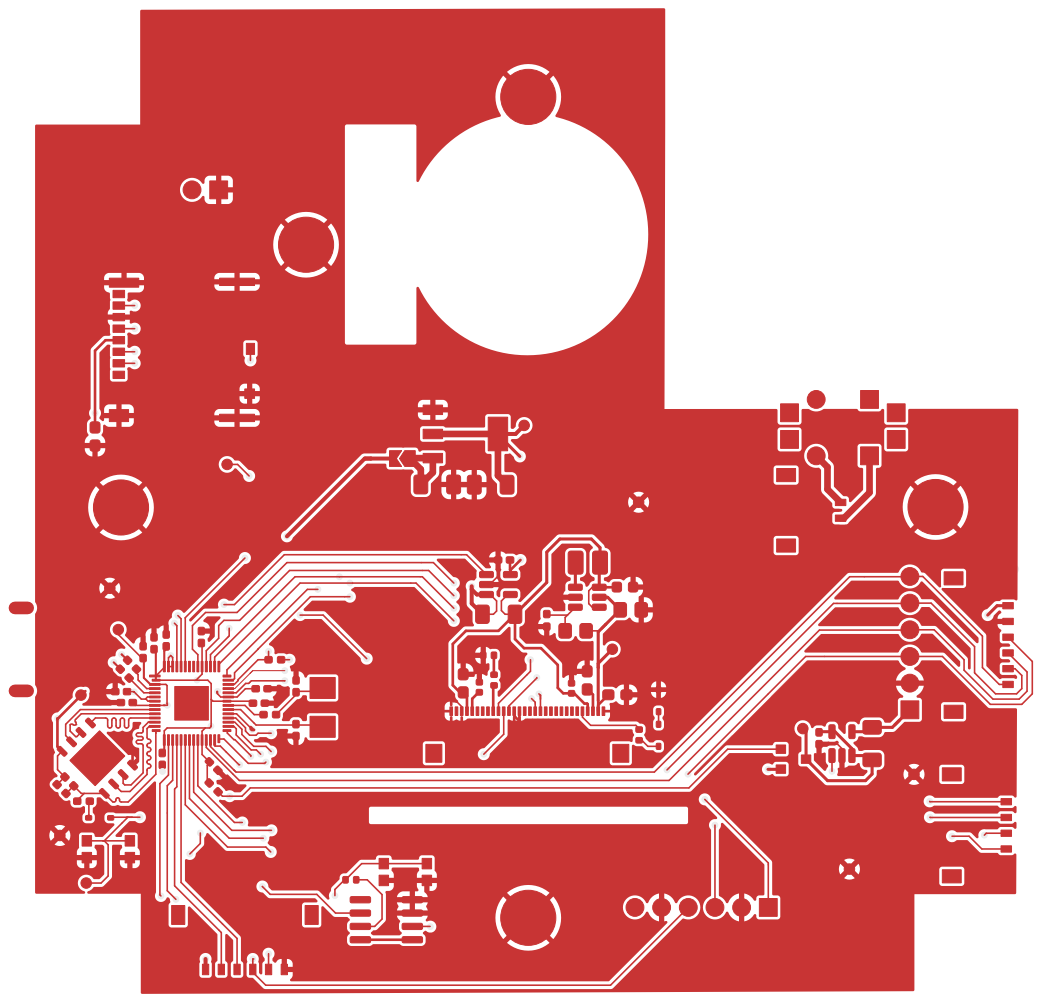
[picture p18: page 1]
