inspireFly-VT/ContentCube_Payload_Board/Manufacturing/payload_board_rev074_gbr/payload_board-F_Mask.pdf

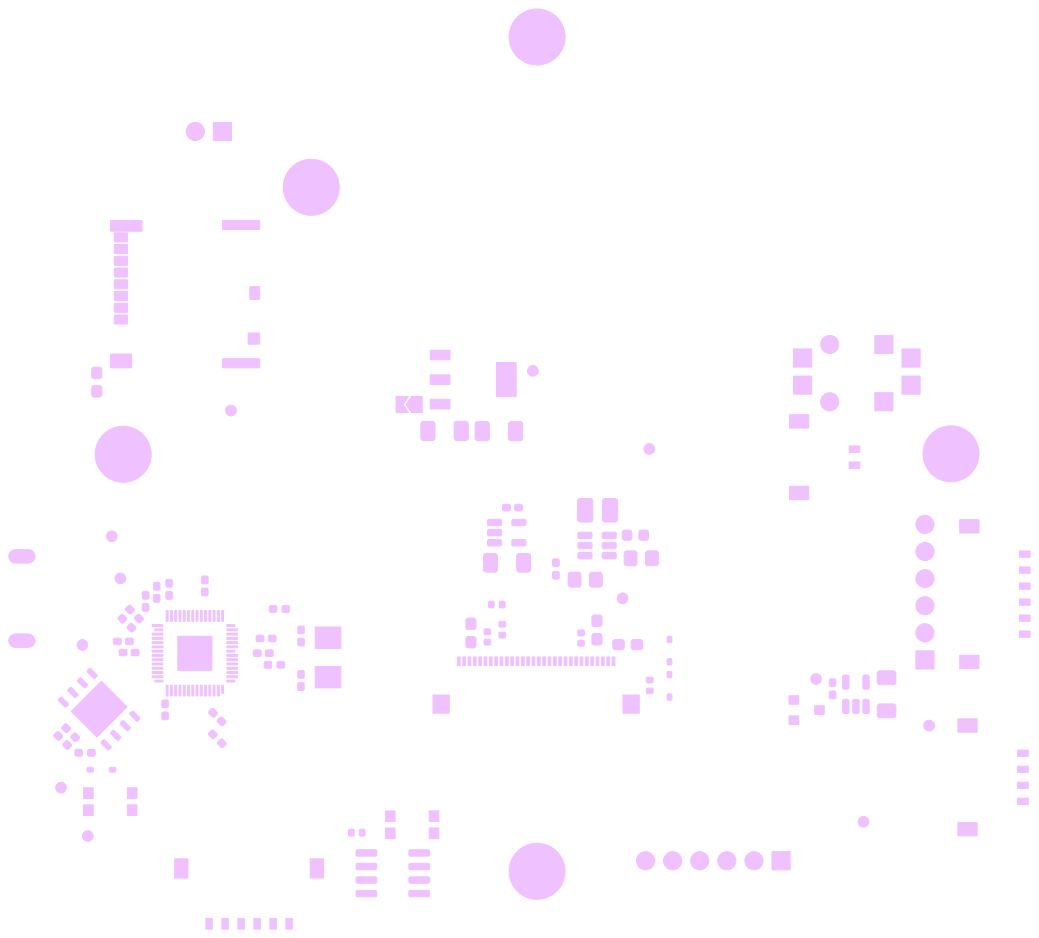
[picture p19: page 1]
