inspireFly-VT/ContentCube_Payload_Board/Manufacturing/payload_board_rev074_gbr/payload_board-F_Silkscreen.pdf

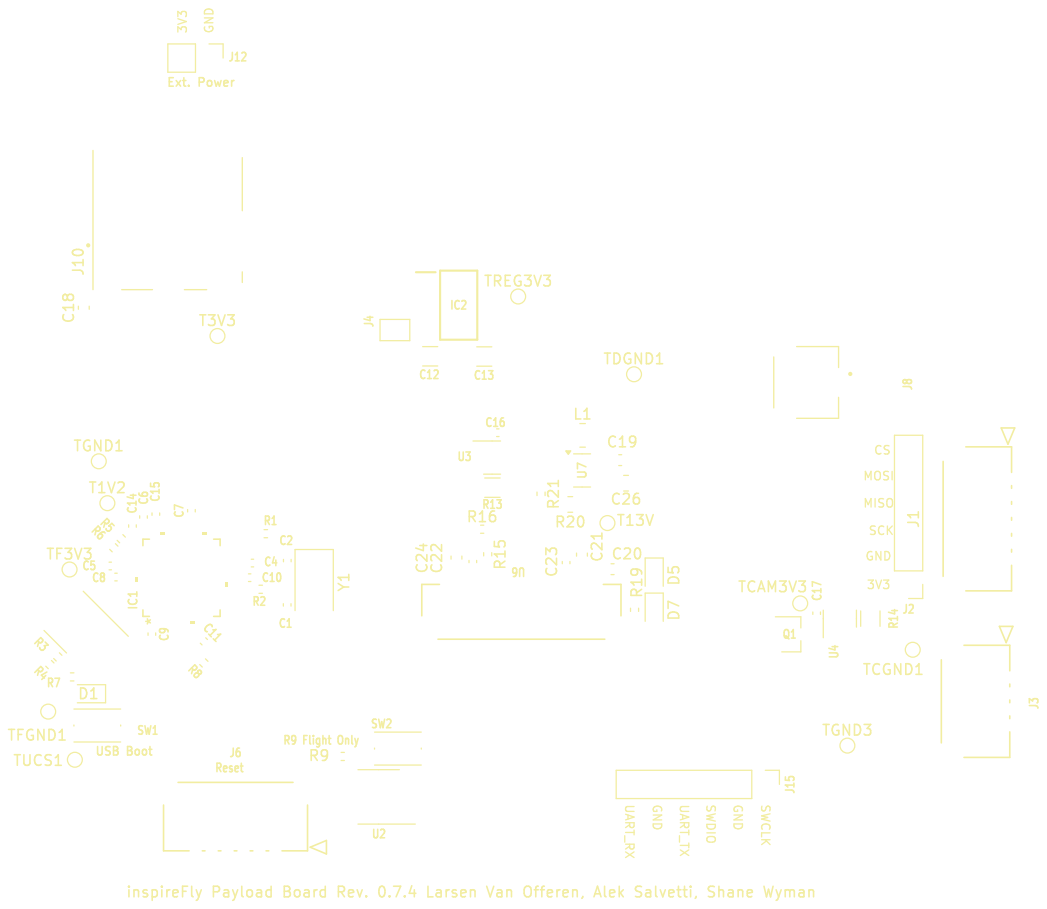
[picture p20: page 1]
