inspireFly-VT/ContentCube_Payload_Board/Manufacturing/payload_board_rev074_gbr/payload_board-In1_Cu.pdf

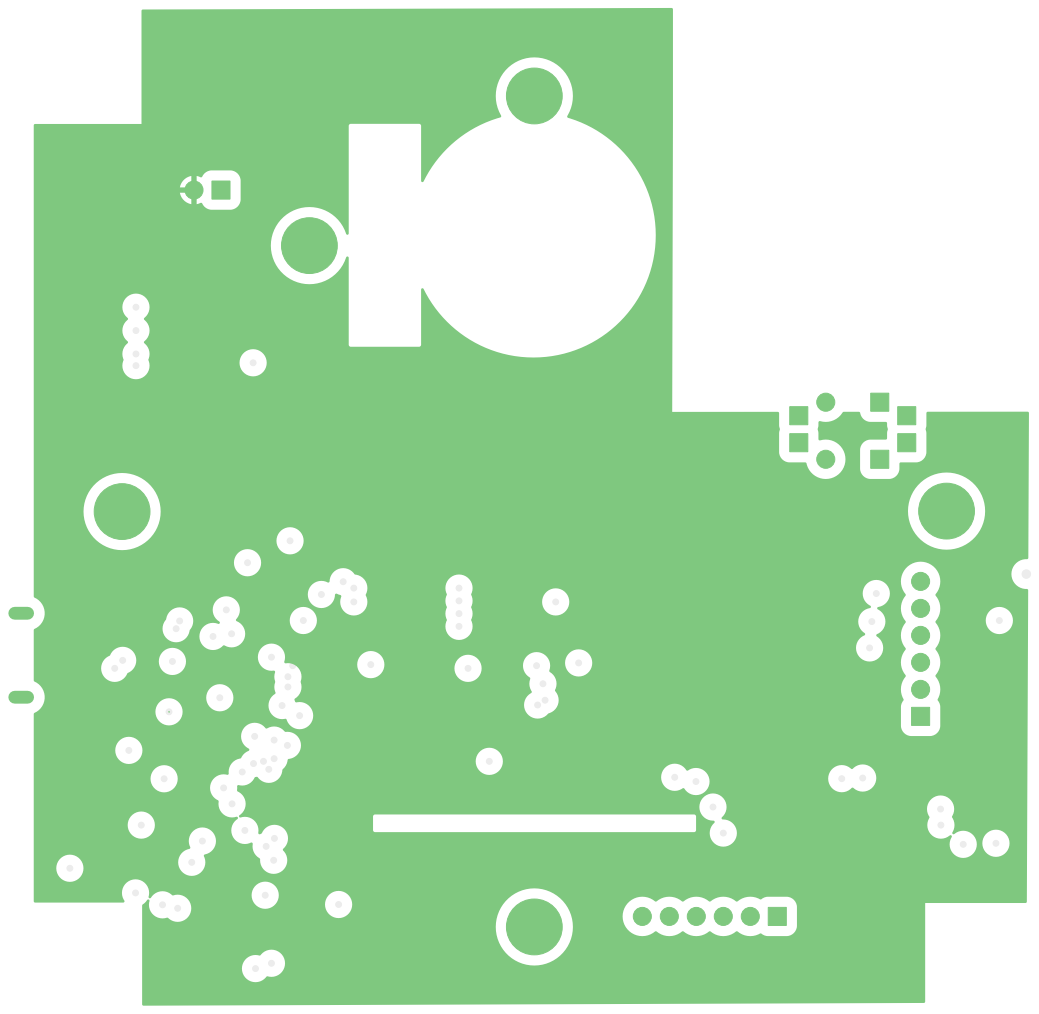
[picture p21: page 1]
