inspireFly-VT/ContentCube_Payload_Board/Manufacturing/payload_board_rev074_gbr/payload_board-In2_Cu.pdf

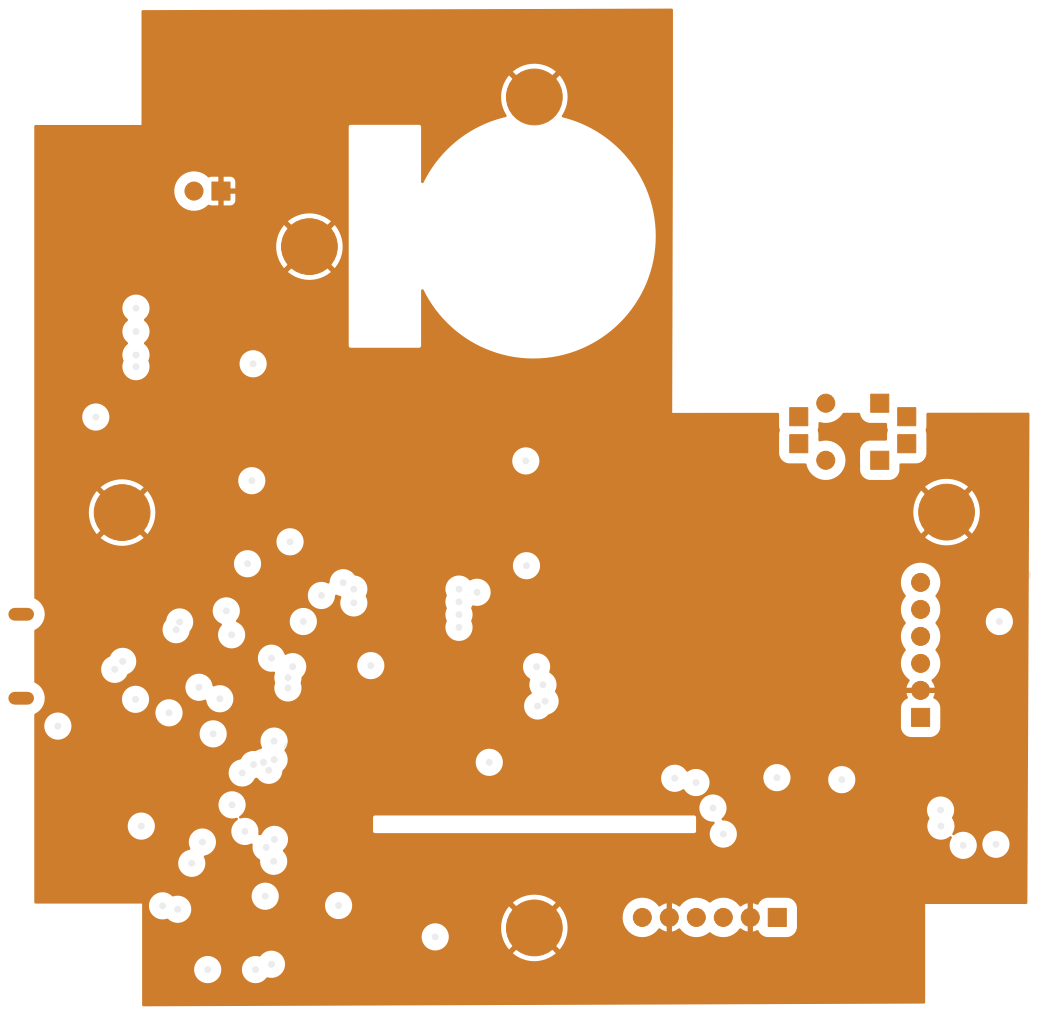
[picture p22: page 1]
