inspireFly-VT/ContentCube_Payload_Board/payload_board.kicad_pcb

## KiCad design payload_board.kicad_pcb (2025-02-18)

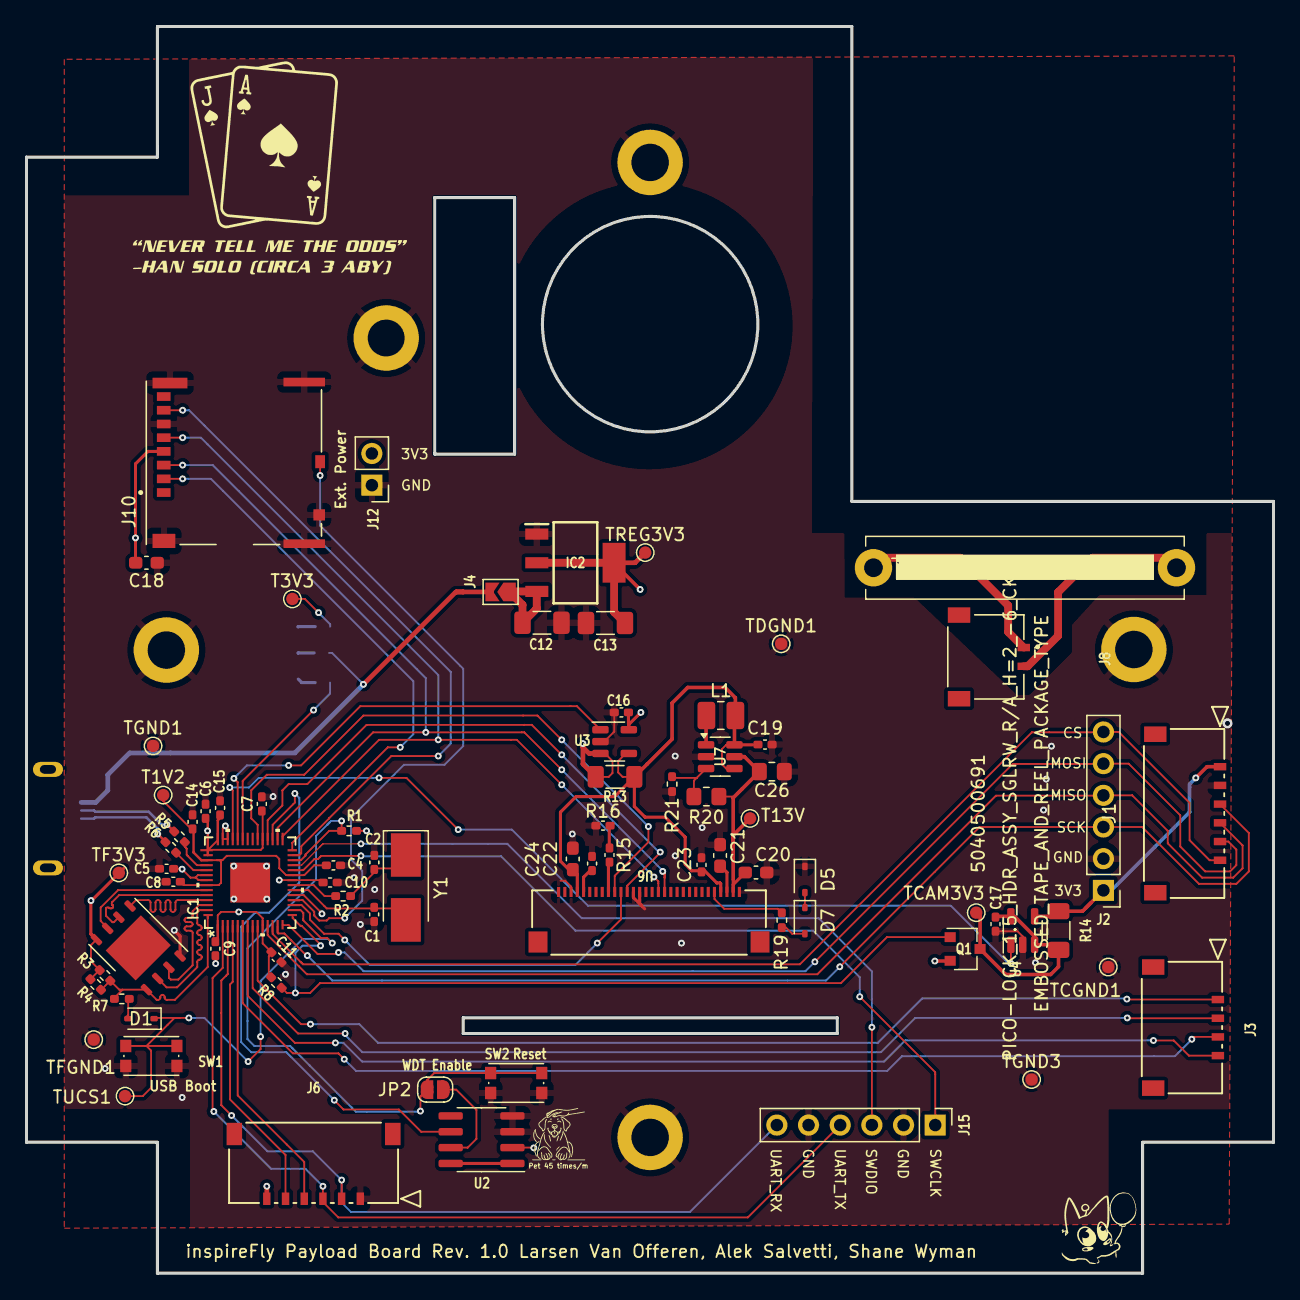
[picture p23: board payload_board.kicad_pcb from above]

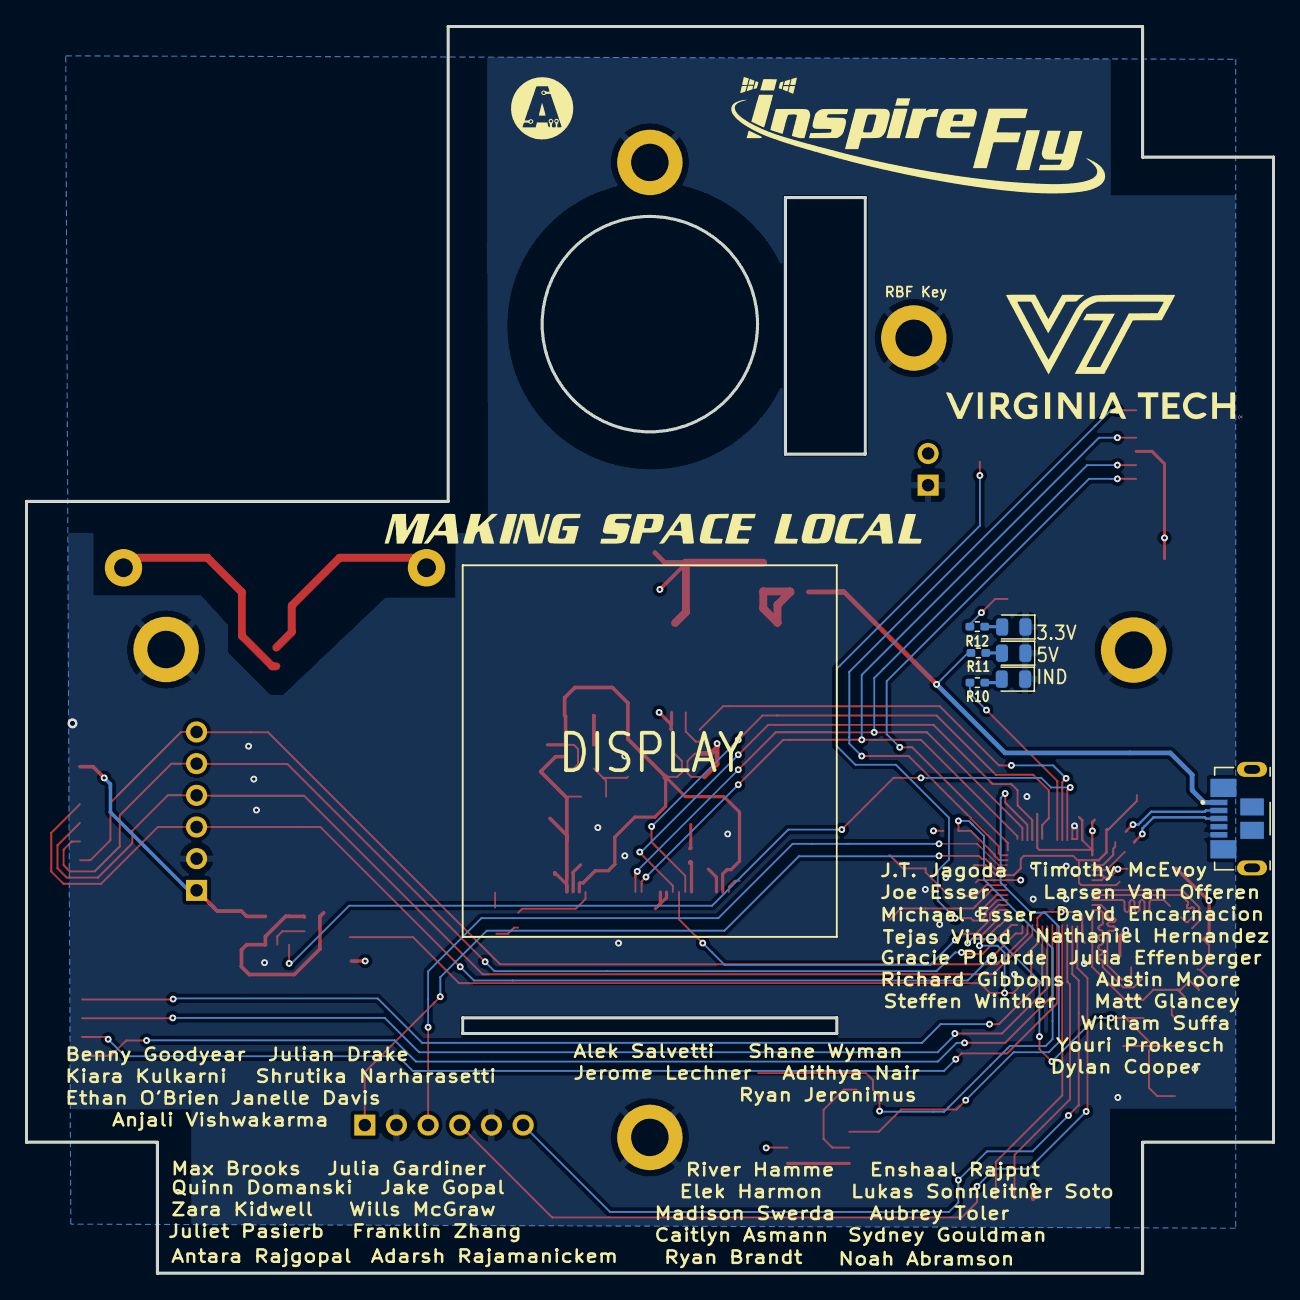
[picture p24: board payload_board.kicad_pcb from below]

Board: 4 copper layers, 100.0 x 100.0 mm, 86 parts (8 on the bottom side), 66 nets.

Parts:
C1, C2: 27pF; C_0402_1005Metric_Pad0.74x0.62mm_HandSolder
C4, C5, C7, C8, C9, C10, C11, C15, C16, C17: 0.1uF; C_0402_1005Metric_Pad0.74x0.62mm_HandSolder
C6, C14, C19: 1uF; C_0402_1005Metric_Pad0.74x0.62mm_HandSolder
C12: 10uF; C_1206_3216Metric_Pad1.33x1.80mm_HandSolder
C13: 22uF; C_1206_3216Metric_Pad1.33x1.80mm_HandSolder
C18, C24: 10uF; C_0603_1608Metric_Pad1.08x0.95mm_HandSolder
C20, C21: 10uF/16V; C_0603_1608Metric_Pad1.08x0.95mm_HandSolder
C22, C23: 1.0uF; C_0402_1005Metric_Pad0.74x0.62mm_HandSolder
C26: 4.7uF; R_0805_2012Metric_Pad1.20x1.40mm_HandSolder
D1, D5, D7: NSR0320; D_SOD-323
D2, D3, D4: LED; LED_0805_2012Metric
IC1: RP2040_QFN56; custom_IC57_RP2040
IC2: AZ1117CH-3.3TRG1; SOT230P700X180-4N
J1: Cam_PicoLock; Molex_Pico_CON_5040500691
J2: Cam_Conn; PinHeader_1x06_P2.54mm_Vertical
J2#2, J5: MountingHoles
J3: Antenna_Conn; Molex_Pico_CON_5040500491
J4: usb jumper; SolderJumper-2_P1.3mm_Open_TrianglePad1.0x1.5mm
J6: Breakout; Molex_Pico_CON_5040500691
J7: Molex_Micro_USB; MOLEX_105164-0001
J8: FC to EPS Connector; MOLEX_504050-0291
J10: 503398-1892; MOLEX_503398-1892
J12: FC Breakout; PinHeader_1x02_P2.54mm_Vertical
J15: SWC; PinHeader_1x06_P2.54mm_Vertical
JP2: SolderJumper_2_Open; SolderJumper-2_P1.3mm_Open_RoundedPad1.0x1.5mm
L1: 10uH/1A; L_1008_2520Metric_Pad1.43x2.20mm_HandSolder
Q1: Q_PMOS_GSD; SC-59
R1, R3, R8: 10k; R_0402_1005Metric_Pad0.72x0.64mm_HandSolder
R2, R7: 1K; R_0402_1005Metric_Pad0.72x0.64mm_HandSolder
R4: DNF; R_0402_1005Metric_Pad0.72x0.64mm_HandSolder
R5, R6: 27.4; R_0402_1005Metric_Pad0.72x0.64mm_HandSolder
R10, R12: 220; R_0402_1005Metric_Pad0.72x0.64mm_HandSolder
R11: 470; R_0402_1005Metric_Pad0.72x0.64mm_HandSolder
R13, R14: 0.065; R_1206_3216Metric_Pad1.30x1.75mm_HandSolder
R15, R16: 300k; C_0402_1005Metric_Pad0.74x0.62mm_HandSolder
R19: 50; R_0402_1005Metric_Pad0.72x0.64mm_HandSolder
R20: 16k; R_0805_2012Metric_Pad1.20x1.40mm_HandSolder
R21: 1k; R_0402_1005Metric_Pad0.72x0.64mm_HandSolder
SW1, SW2: KMR2; SW_Push_1P1T_NO_CK_KMR2
T1V2, T3V3, T13V: TESTPOINTROUND1.5MMNO; TestPoint_Pad_D1.0mm
TCAM3V3: TESTPOINTROUND1.5MMNO; TestPoint_Pad_D1.0mm
TCGND1: TESTPOINTROUND1.5MMNO; TestPoint_Pad_D1.0mm
TDGND1: TESTPOINTROUND1.5MMNO; TestPoint_Pad_D1.0mm
TF3V3: TESTPOINTROUND1.5MMNO; TestPoint_Pad_D1.0mm
TFGND1: TESTPOINTROUND1.5MMNO; TestPoint_Pad_D1.0mm
TGND1, TGND3: TESTPOINTROUND1.5MMNO; TestPoint_Pad_D1.0mm
TREG3V3: TESTPOINTROUND1.5MMNO; TestPoint_Pad_D1.0mm
TUCS1: TESTPOINTROUND1.5MMNO; TestPoint_Pad_D1.0mm
U1: W25Q128JVPIQ TR; WDFN-8-1EP_6x5mm_P1.27mm_EP3.4x4mm
U2: MAX706RESA; SOIC-8_3.9x4.9mm_P1.27mm
U3, U4: INA180A3; SOT-23-5
U6: CON30_1X30_DRB_XF2C_TYC
U7: TLV61046ADB; SOT-23-6
Y1: ABLS-12.000MHZ-B2-T; Crystal_SMD_5032-2Pin_5.0x3.2mm_HandSoldering

Connections:
1.2V: C4.2, C5.2, C14.2, IC1.23 (DVDD), IC1.45 (VREG_VOUT), IC1.50 (DVDD), T1V2.1
+3.3V: C6.2, C7.1, C8.1, C9.1, C10.1, C11.1, C13.1, C15.1, C16.1, C18.2, IC1.1 (IOVDD), IC1.10 (IOVDD), IC1.22 (IOVDD), IC1.33 (IOVDD), IC1.42 (IOVDD), IC1.43 (ADC_IOVDD), IC1.44 (VREG_IOVDD), IC1.48 (USB_IOVDD), IC1.49 (IOVDD), IC2.2 (OUTPUT), IC2.4 (VOUT), J6.6, J10.4 (VDD), J12.2, Q1.2 (S), R1.1, R3.1, R4.2, R8.2, R12.2, R13.2, T3V3.1, TF3V3.1, TREG3V3.1, U1.8 (VCC), U2.2 (VCC), U3.3 (+), U3.5 (V+)
+13V: C20.2, C26.2, R20.1, T13V.1, U6.P$29 (VCC), U7.5 (VOUT)
/D+: J7.3 (D+), R6.1
/D-: J7.2 (D-), R5.2
/QSPI_CS: IC1.56 (~QSPI_CS), R3.2, R4.1, R7.1, U1.1 (SSEL)
/QSPI_DATA[0]: IC1.53 (QSPI_SD0), U1.5 (MOSI)
/QSPI_DATA[1]: IC1.55 (QSPI_SD1), U1.2 (MISO)
/QSPI_DATA[2]: IC1.54 (QSPI_SD2), U1.3 (WP#/IO2)
/QSPI_DATA[3]: IC1.51 (QSPI_SD3), U1.7 (HOLD#/IO3)
/QSPI_SCK: IC1.52 (QSPI_SCLK), U1.6 (SCK)
/USBBOOT: D1.1 (C), IC1.16 (GPIO13), SW1.1, TUCS1.1
/~RESET: IC1.26 (/RUN), JP2.2 (B), R1.2, SW2.1
ADC0: IC1.38 (GPIO26/AD0), U3.1
ADC1: IC1.39 (GPIO27/AD1), U4.1
BURN_A: IC1.8 (GPIO6), J3.2
BURN_B: IC1.9 (GPIO7), J3.1
Break_SCL: IC1.5 (GPIO3), J6.4
Break_SDA: IC1.4 (GPIO2), J6.5
CIN-: J1.1, J2.1, R14.2, U4.4 (-)
Cam_3.3v: C17.2, Q1.3 (D), R14.1, TCAM3V3.1, U4.3 (+), U4.5 (V+)
Cam_RST: IC1.15 (GPIO12), Q1.1 (G), R8.1
DIN-: C19.2, C23.2, C24.2, L1.1, R13.1, U3.4 (-), U6.P$4 (VCI), U6.P$27 (VDDIO), U7.4 (EN), U7.6 (VI)
Disp_DC: IC1.17 (GPIO14), U6.P$11 (D/C#)
Disp_RST: IC1.34 (GPIO22), U6.P$10 (RES#)
GND: C1.1, C2.1, C4.1, C5.1, C6.1, C7.2, C8.2, C9.2, C10.2, C11.2, C12.2, C13.2, C14.1, C15.2, C16.2, C17.1, C18.1, C19.1, C20.1, C21.1, C22.1, C23.1, C24.1, C26.1, D2.1 (K), D3.1 (K), D4.1 (K), D5.1 (C), IC1.19 (TESTEN), IC1.40 (GPIO28/AD2), IC1.41 (GPIO29/AD3), IC1.57, IC2.1 (ADJ/GND), J1.2, J2.2, J2#2.1 (VTref), J5.1, J6.1, J7.5 (GND), J10.6 (VSS), J10.9 (VSS__1), J10.P1 (SHIELD), J10.P2 (SHIELD__1), J10.P3 (SHIELD__2), J10.P4 (SHIELD__3), J12.1, J15.2, J15.5, R16.1, R21.2, SW1.2 (S), SW2.2 (S1), TCGND1.1, TDGND1.1, TFGND1.1, TGND1.1, TGND3.1, U1.4 (VSS), U2.3 (GND), U2.4 (PFI), U3.2 (GND), U4.2 (GND), U6.P$1 (NC(GND)@2), U6.P$3 (VSS), U6.P$13 (BS1), U6.P$14 (BS0), U6.P$30 (NC(GND)@1), U7.2 (GND)
I2C1_SCL: IC1.7 (GPIO5), J3.4
I2C1_SDA: IC1.6 (GPIO4), J3.3
unnamed: C2.2, R2.1, Y1.1
unnamed: D1.2 (A), R7.2
unnamed: D2.2 (A), R10.1
unnamed: D3.2 (A), R11.1
unnamed: D4.2 (A), R12.1
unnamed: D5.2 (A), D7.1 (C)
unnamed: D7.2 (A), R19.1
unnamed: IC1.37 (GPIO25), R10.2
unnamed: IC1.47 (USB_D+), R6.2
unnamed: IC1.46 (USB_D-), R5.1
unnamed: C1.2, IC1.20 (XIN), Y1.2
unnamed: IC1.21 (XOUT), R2.2
unnamed: JP2.1 (A), U2.7 (~RESET)
unnamed: R15.1, R16.2
unnamed: U2.1 (~MR), U2.8 (~WDO)
unnamed: R15.2, U6.P$9 (IREF)
unnamed: C21.2, U6.P$28 (VCOMH)
unnamed: C22.2, U6.P$5 (VDD)
unnamed: R19.2, U6.P$26 (VSL)
unnamed: R20.2, R21.1, U7.3 (FB)
unnamed: L1.2, U7.1 (SW)
SD_IND: IC1.18 (GPIO15), J10.10 (DETECT_SWITCH)
SPI0_CS_DISP: IC1.32 (GPIO21), U6.P$12 (CS#)
SPI0_CS_SD: IC1.28 (GPIO17), J10.2 (CD/DAT3^2)
SPI0_MISO: IC1.27 (GPIO16), J10.7 (DAT0)
SPI0_MOSI: IC1.30 (GPIO19), J10.3 (CMD), U6.P$18 (D1/SDIN)
SPI0_SCK: IC1.29 (GPIO18), J10.5 (CLK), U6.P$17 (D0/SCK)
SPI1_CS_Cam: IC1.12 (GPIO9), J1.6, J2.6
SPI1_MISO_Cam: IC1.11 (GPIO8), J1.4, J2.4
SPI1_MOSI_Cam: IC1.14 (GPIO11), J1.5, J2.5
SPI1_SCK_Cam: IC1.13 (GPIO10), J1.3, J2.3
SWCLK: IC1.24 (SWCLK), J15.1
SWDIO: IC1.25 (SWDIO), J15.3
UART1_RX: IC1.3 (GPIO1), J6.2, J15.6
UART1_TX: IC1.2 (GPIO0), J6.3, J15.4
VBUS: J4.2 (B), J7.1 (VBUS), R11.2
VUR: C12.1, IC2.3 (INPUT), J4.1 (A)
WDT_WDI: IC1.31 (GPIO20), U2.6 (~WDI)
