inspireFly-VT/ContentCube_Payload_Board/Documentation/Adafruit-1.5-display/camera_oled_software/inspireFly_soft_08_25_24_1240/uart_packer.py

def wrapper(command:bytes):
    message = b'\x3C' #'<'
    message = message + command
    message = message + b'\x3E'
    return message

def stripper(command:bytes):
    message = command[1:-1]
    return message
