inspireFly-VT/ContentCube_Payload_Board/(commit log)

2024-10-15 Port from CADLAB to Github
    [payload_board.kicad_pcb, payload_board.kicad_sch, payload_board.xlsx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]
2024-10-16 Updated component placements and footprints
    [payload_board.kicad_pcb, payload_board.kicad_sch]
2024-10-17 Updated display footprints to reflect avaliability
    [payload_board.csv, payload_board.kicad_pcb, payload_board.kicad_sch, payload_board.xlsx]
2024-10-19 Changed the orientation of the connector to align, and moved a couple of the components Will continue tomorrow
    [payload_board.kicad_pcb]
2024-10-19 Forgot to save changes for schematic
    [payload_board.kicad_sch]
2024-10-19 Rotated it back (by bad i dont know how to read schematics) and added some connections
    [payload_board.kicad_pcb]
2024-10-19 Connected some more stuff
    [payload_board.kicad_pcb]
2024-10-20 Moved the sd card on the board
    [payload_board.kicad_pcb]
2024-10-20 oops, forgot to connect some of the gnd pins
    [payload_board.kicad_pcb]
2024-10-20 Some of the planes where unconnected
    [payload_board.kicad_pcb]
2024-10-20 Moved some of the traces further appart
    [payload_board.kicad_pcb]
2024-10-20 A little more
    [payload_board.kicad_pcb]
2024-10-20 Final move
    [payload_board.kicad_pcb]
2024-10-20 moved some of the silkcreen labels
    [payload_board.kicad_pcb]
2024-10-20 Moved some line appart
    [payload_board.kicad_pcb]
2024-10-20 Inventory of the components
    [payload_board.xlsx]
2024-10-23 Fixed RP2040 connections and changed sd card
    [payload_board.kicad_pcb, payload_board.kicad_sch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]
2024-10-23 changed footprint for sd card and fixed not gnd planes
    [payload_board.kicad_pcb]
2024-10-23 Fixed some errors and added manufactering file
    [payload_board-B_Cu.gbr, payload_board-B_Mask.gbr, payload_board-B_Silkscreen.gbr, payload_board-Edge_Cuts.gbr, payload_board-F_Cu.gbr, payload_board-F_Mask.gbr, payload_board-F_Silkscreen.gbr, payload_board-In1_Cu.gbr]
2024-10-25 Update BOM and part identifiers on PCB
    [payload_board.csv, payload_board.kicad_pcb, payload_board.xlsx]
2024-10-26 Updated inventory (payload_board.xlsx)
    [payload_board.xlsx]
2024-10-27 Updated footprints
    [payload_board-B_Cu.gbr, payload_board-B_Mask.gbr, payload_board-B_Silkscreen.gbr, payload_board-Edge_Cuts.gbr, payload_board-F_Cu.gbr, payload_board-F_Mask.gbr, payload_board-F_Silkscreen.gbr, payload_board-In1_Cu.gbr]
2024-10-28 Finalized part selection and gbr for 073 manufacturing.
    [payload_board-B_Cu.gbr, payload_board-B_Mask.gbr, payload_board-B_Silkscreen.gbr, payload_board-Edge_Cuts.gbr, payload_board-F_Cu.gbr, payload_board-F_Mask.gbr, payload_board-F_Silkscreen.gbr, payload_board-In1_Cu.gbr]
2024-10-31 Flipped the outline and moved the screen and some of the connectors Now the front in Kicad is the back in the satelite (inside) and vice versa
    [payload_board.kicad_pcb, payload_board_rev073_outline.DXF]
2024-11-01 Moved the final connector from back to front, footprint kepout for chasis mounts and moved sd card
    [payload_board.kicad_pcb]
2024-11-03 Changed some components to decrease bom count (C18, C25)
    [payload_board.kicad_pcb, payload_board.kicad_sch]
2024-11-03 Add JLC Part identifiers
    [JLCPCB_BOM_PayloadBoard.xls, payload_board.xlsx]
2024-11-05 Updated footprints to reduce part count.
    [payload_board.kicad_pcb, payload_board_074.csv]
2024-11-05 flipped camera power monitor and reset
    [payload_board.kicad_pcb]
2024-11-08 stuck with new buck converter Trying to understand why BOOT is limited to 10 V, even if output is supposed to be 14V
    [payload_board.kicad_sch]
2024-11-09 Update for JLC PCBA part selection
    [JLCPCB_BOM_PayloadBoard.xls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]
2024-11-09 Added new 13V boost converter
    [payload_board.kicad_pcb, payload_board.kicad_sch]
2024-11-10 Added .gitignore for Kicad temp files and updated bom for JLC parts
    [JLCPCB_BOM_PayloadBoard.xls]
2024-11-14 Update placement blocking connectors
    [payload_board.kicad_pcb]
2024-11-16 Updated footprints to refelct part avaliability
    [JLCPCB_BOM_PayloadBoard.xls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]
2024-11-18 Change part selection to reflect avaliability
    [payload_board.kicad_pcb, payload_board.kicad_sch]
2024-12-05 Added alternative 13v regulator setup for testing
    [13vconvertertest-B_Cu.gbr, 13vconvertertest-B_Mask.gbr, 13vconvertertest-B_Paste.gbr, 13vconvertertest-B_Silkscreen.gbr, 13vconvertertest-Edge_Cuts.gbr, 13vconvertertest-F_Cu.gbr, 13vconvertertest-F_Mask.gbr, 13vconvertertest-F_Paste.gbr]
2024-12-06 Updated Some placements and DNP flags for manu.
    [payload_board.kicad_pcb]
2024-12-08 Fixed some unconected traces
    [JLCPCB_BOM_PayloadBoard_BACKUP_20359.xls, JLCPCB_BOM_PayloadBoard_BACKUP_20588.xls, JLCPCB_BOM_PayloadBoard_BACKUP_20710.xls, JLCPCB_BOM_PayloadBoard_BACKUP_20878.xls, JLCPCB_BOM_PayloadBoard_BASE_20359.xls, JLCPCB_BOM_PayloadBoard_BASE_20588.xls, JLCPCB_BOM_PayloadBoard_BASE_20710.xls, JLCPCB_BOM_PayloadBoard_BASE_20878.xls]
2024-12-08 Modified the 13V booster planes
    [payload_board.kicad_pcb]
2024-12-08 Switched to cleaner circle
    [payload_board.kicad_pcb]
2025-01-23 Fixed the RP2040 Ground Pad
    [payload_board.kicad_pcb]
2025-01-23 Moved ribbon hole by 0.8 mm down
    [payload_board.kicad_pcb]
2025-01-23 Added display footprint
    [payload_board.kicad_pcb]
2025-01-29 Updated logos and symbols
    [payload_board.kicad_pcb]
2025-02-02 Updated Graphics
    [JLCPCB_BOM_PayloadBoard_BACKUP_20359.xls, JLCPCB_BOM_PayloadBoard_BACKUP_20588.xls, JLCPCB_BOM_PayloadBoard_BACKUP_20710.xls, JLCPCB_BOM_PayloadBoard_BACKUP_20878.xls, JLCPCB_BOM_PayloadBoard_BASE_20359.xls, JLCPCB_BOM_PayloadBoard_BASE_20588.xls, JLCPCB_BOM_PayloadBoard_BASE_20710.xls, JLCPCB_BOM_PayloadBoard_BASE_20878.xls]
2025-02-03 Updated files for manufacturing
    [JLCPCB_BOM_PayloadBoard.xls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]
2025-02-03 Updated for v1.0 manufacturing
    [payload_board-B_Cu.gbr, payload_board-B_Mask.gbr, payload_board-B_Silkscreen.gbr, payload_board-Edge_Cuts.gbr, payload_board-F_Cu.gbr, payload_board-F_Mask.gbr, payload_board-F_Silkscreen.gbr, payload_board-In1_Cu.gbr]
2025-02-07 Updated for manufacturing
    [13vconvertertest-B_Cu.gbr, 13vconvertertest-B_Mask.gbr, 13vconvertertest-B_Paste.gbr, 13vconvertertest-B_Silkscreen.gbr, 13vconvertertest-Edge_Cuts.gbr, 13vconvertertest-F_Cu.gbr, 13vconvertertest-F_Mask.gbr, 13vconvertertest-F_Paste.gbr]
2025-02-12 added connector diagram
    [connectors.kicad_sch]
2025-02-18 added meme
    [payload_board.kicad_pcb, payload_board.kicad_sch]
